LinesKing/Electronic-System-Design-ELEN90053_2021_SM2-/README.md

# Electronic-System-Design-ELEN90053_2021_SM2-
Electronic System Design (ELEN90053_2021_SM2)
