LinesKing/Electronic-System-Design-ELEN90053_2021_SM2-/Presentation.pptx

PCB 1048669

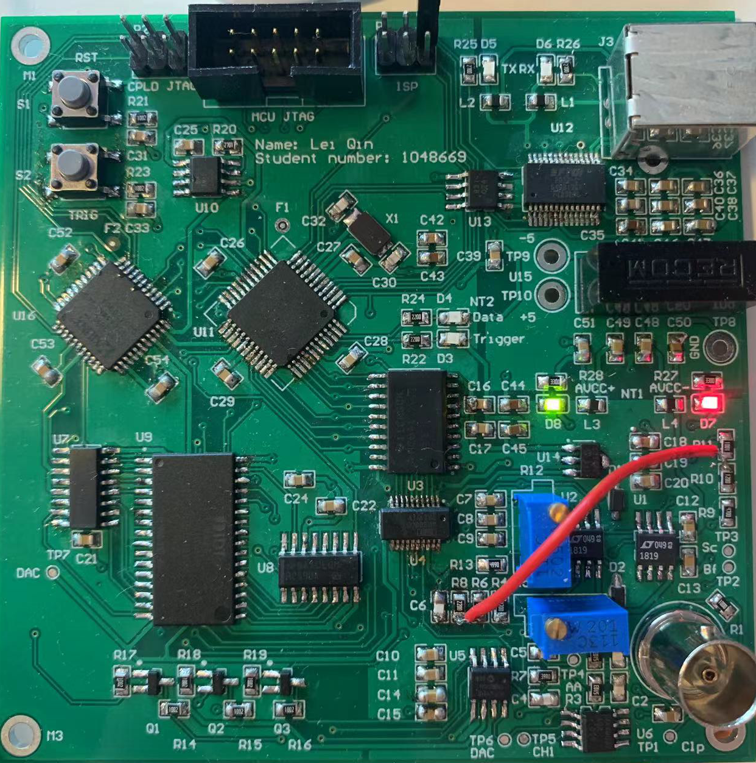
[picture p1: figure]

## Slide 2

Power

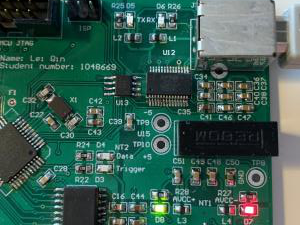
[picture p2: figure]
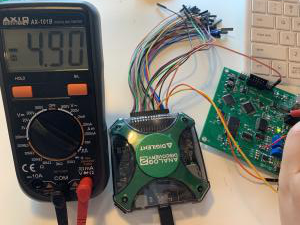
[picture p3: figure]
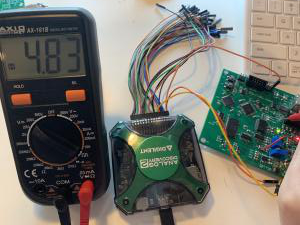
[picture p4: figure]

VCC+

VCC-

## Slide 3

Front End

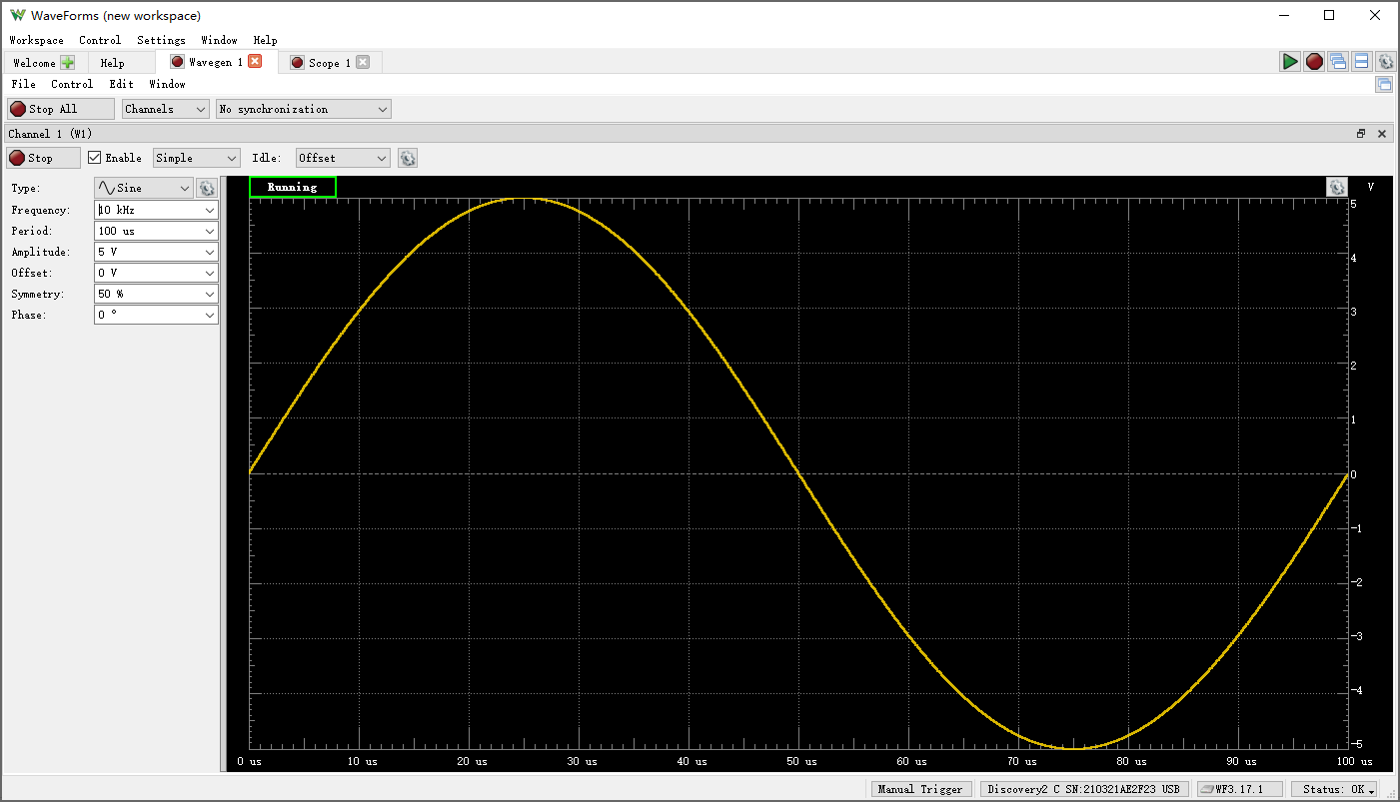
[picture p5: figure]

BNC Input

## Slide 4

Front End

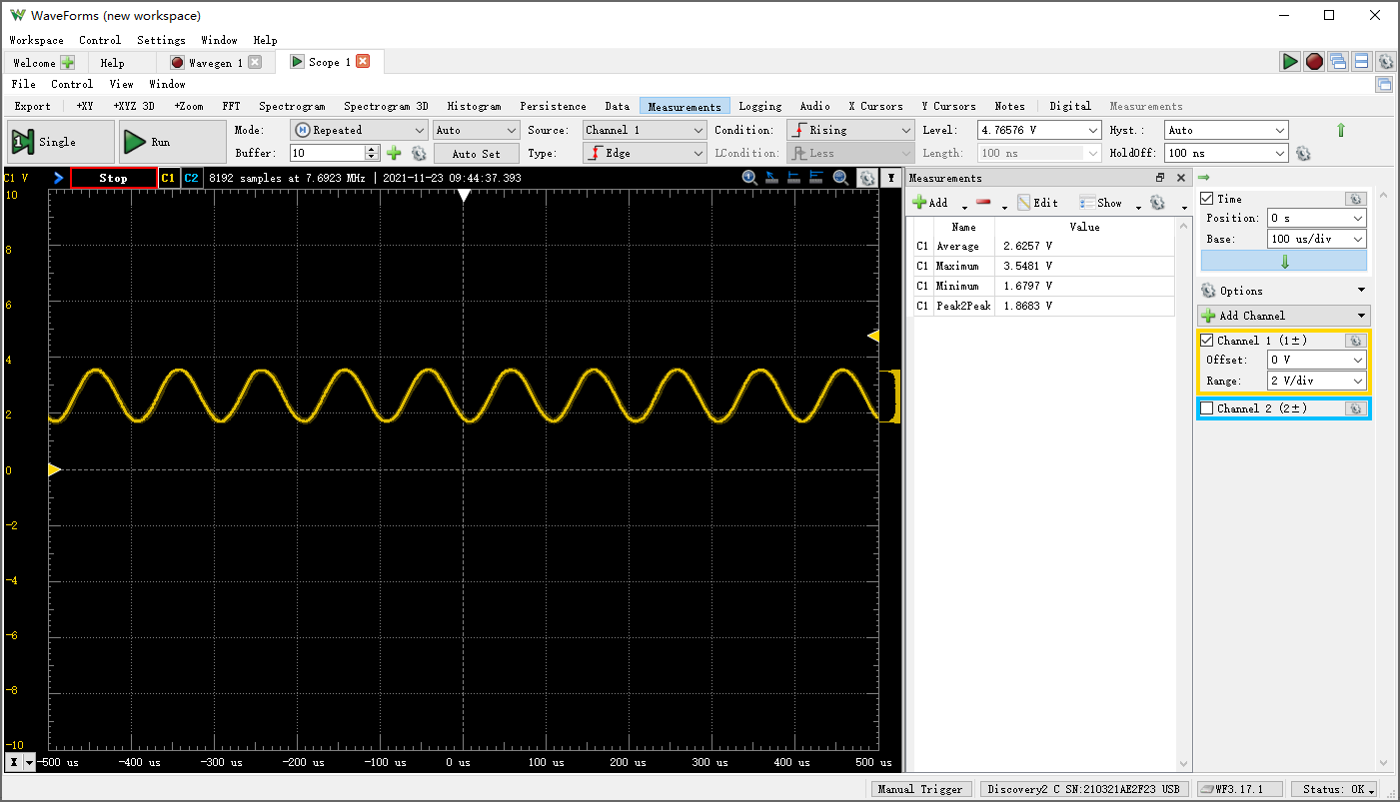
[picture p6: figure]

ADC Input

## Slide 5

GUI

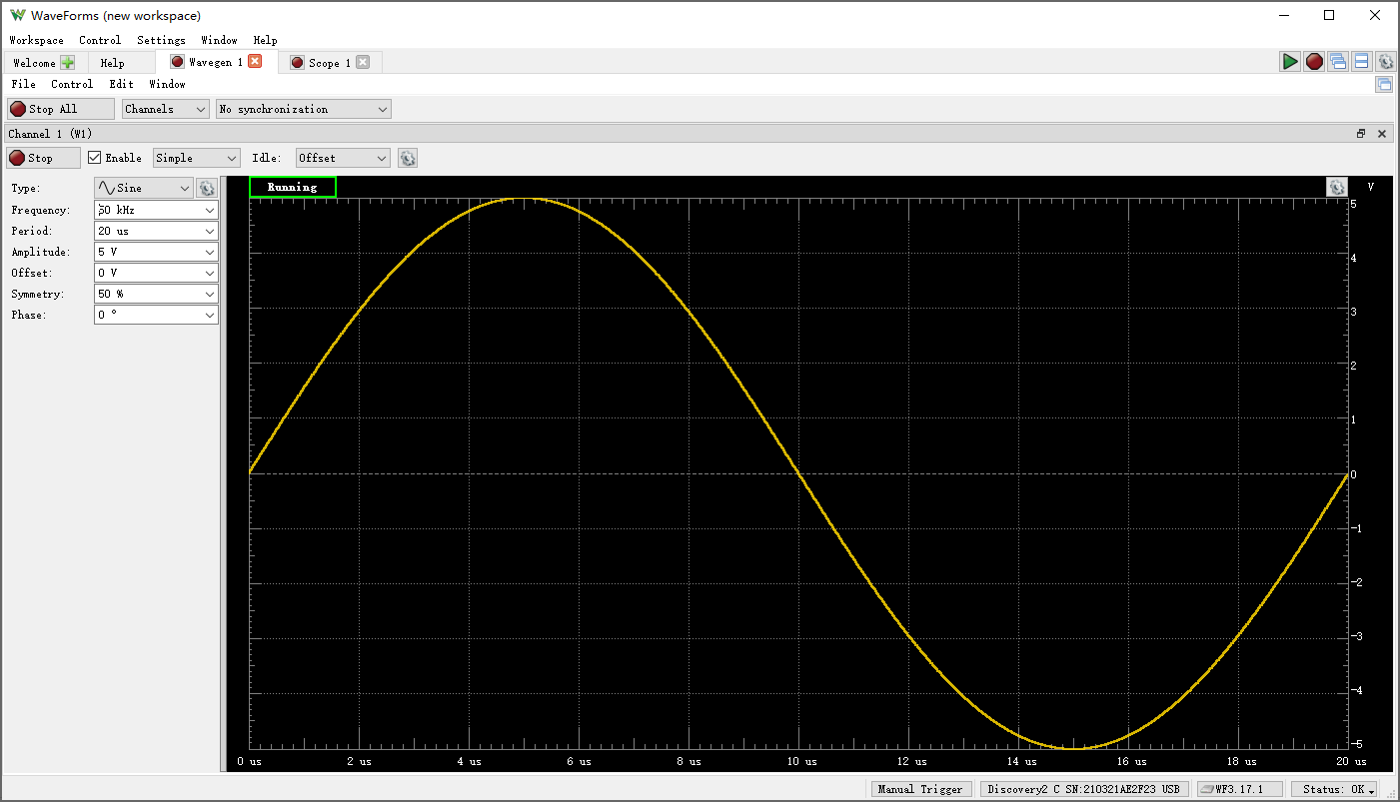
[picture p7: figure]

BNC Input

## Slide 6

GUI

GUI output

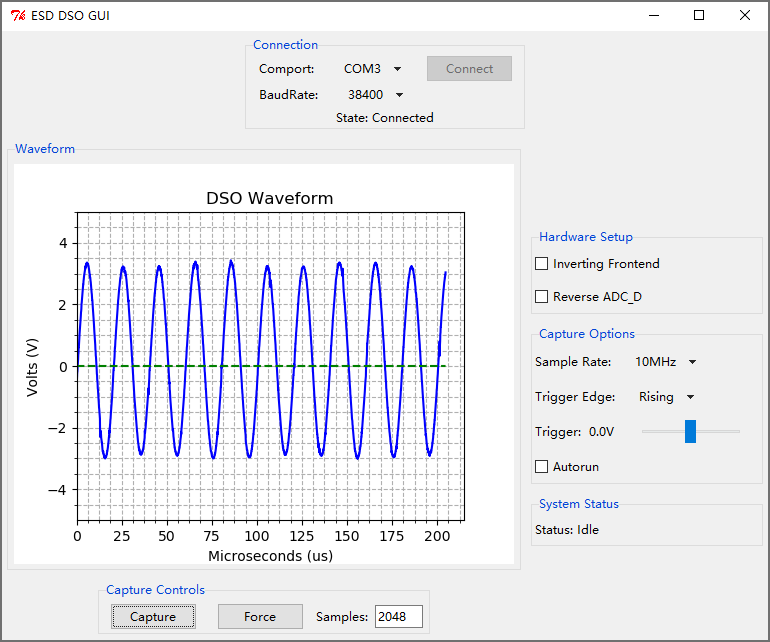
[picture p8: figure]

## Slide 7

Block Diagram

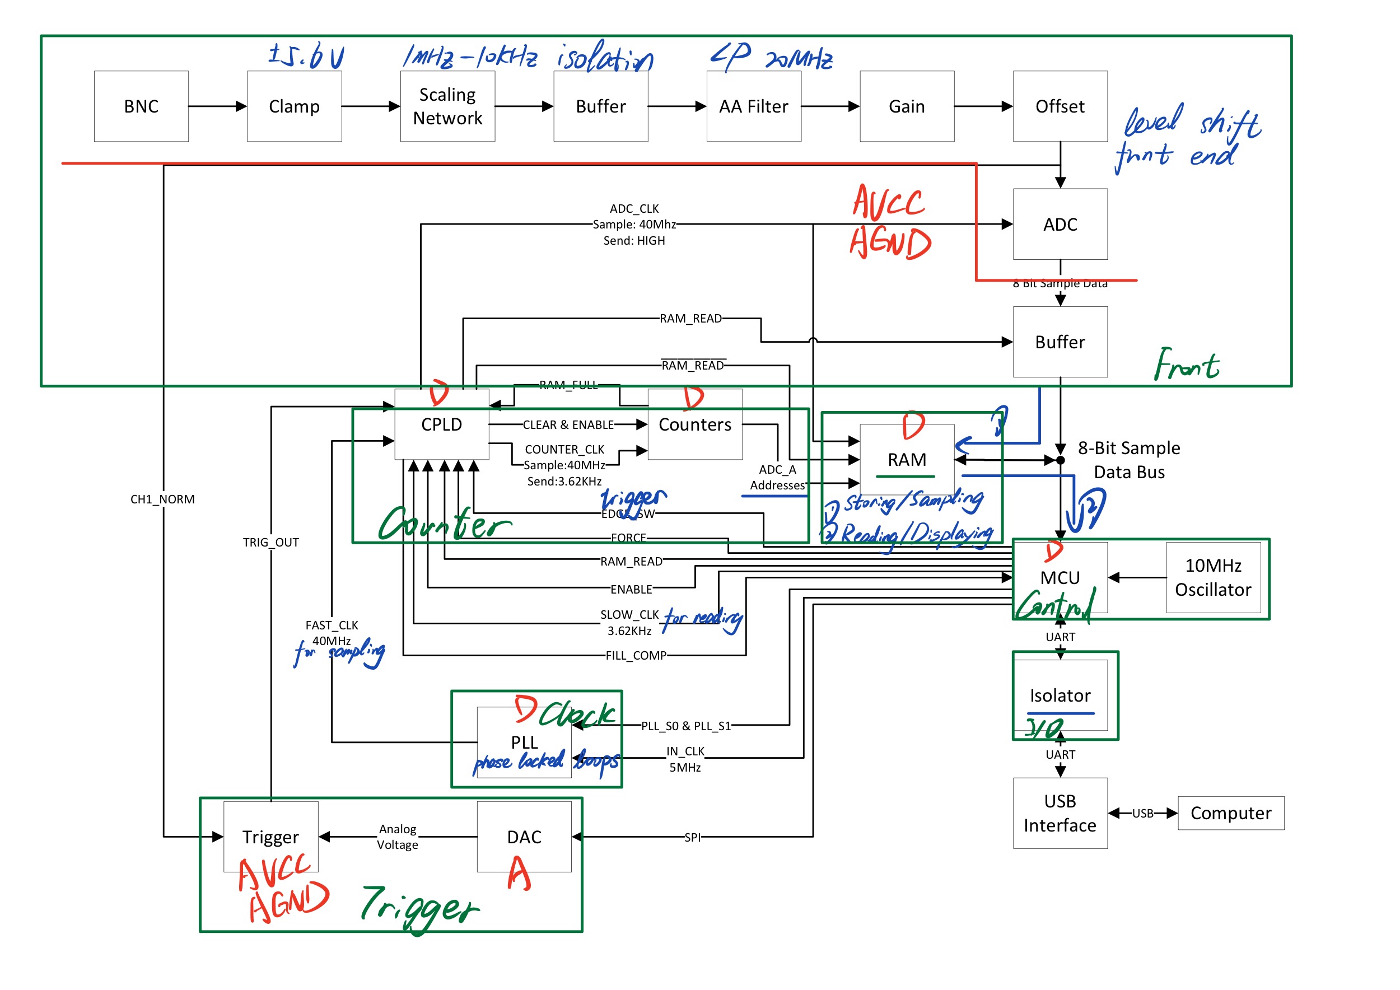
[picture p9: figure]
