LinesKing/Electronic-System-Design-ELEN90053_2021_SM2-/DSO Assignment 1/ESD_DSO_Project.pdf

# Contents

1 Schematics and Simulation Results | 1
2 Discussion | 7
3 Observation | 16
4 Summary | 17
Appendix | 18

# 1 Schematics and Simulation Results

The front end design including power, clamper, scaling, buffer, anti-aliasing filter and invert-

ing level shifter is shown in figure 1.1.

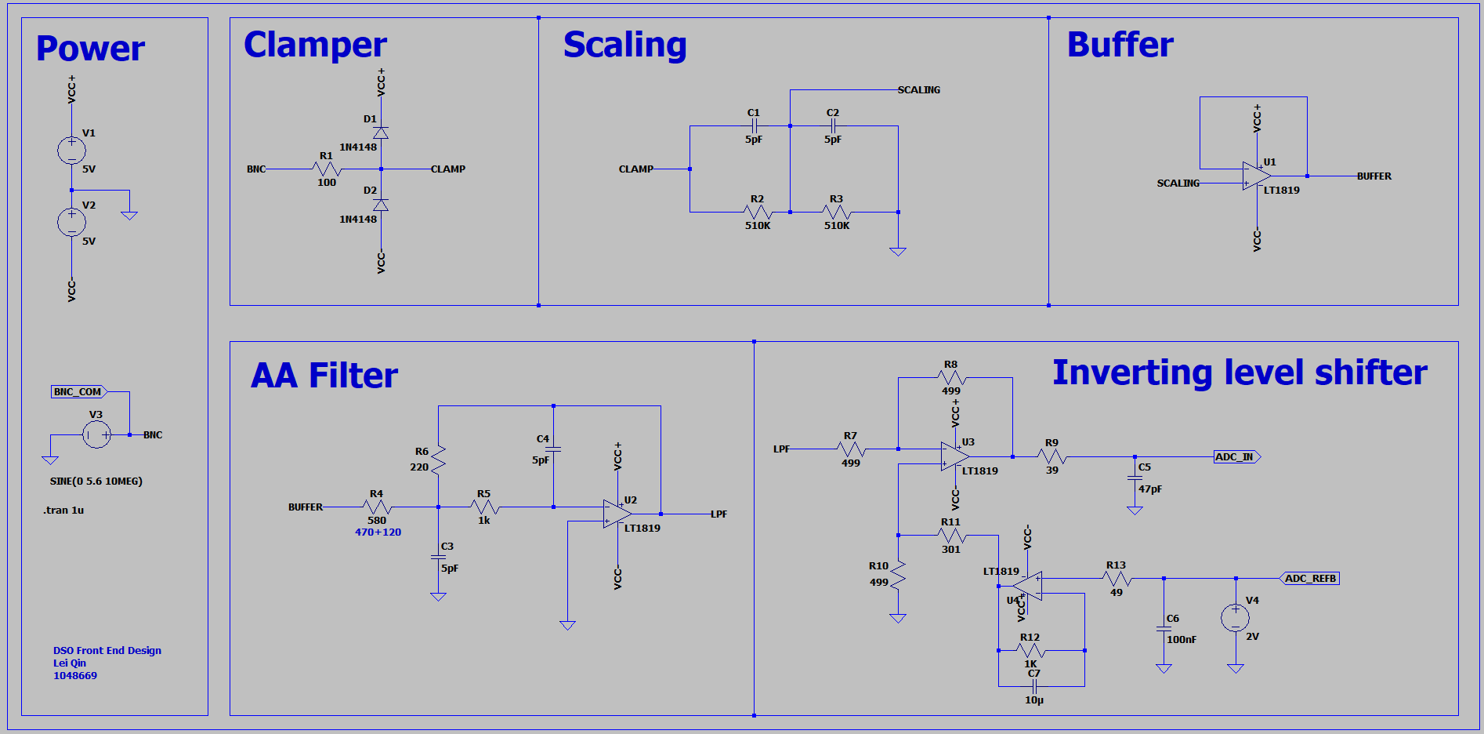
[picture p30: figure]

Figure 1.1: Front End design schematic.

## 1.1 Frequency response at the ADC input

The magnitude and phase response at the ADC input are shown in figure 1.2 and figure 1.3.

The magnitude at 1H z and 18.72M H z are about −14.68dB and −17.67dB. Thus , the cut

off frequency is about 18.72M H z. The phase at 18.72M H z is about −73.755◦ which is larger

than −180◦
. The response is of more than 20dB per decade and less than 2dB ripple.

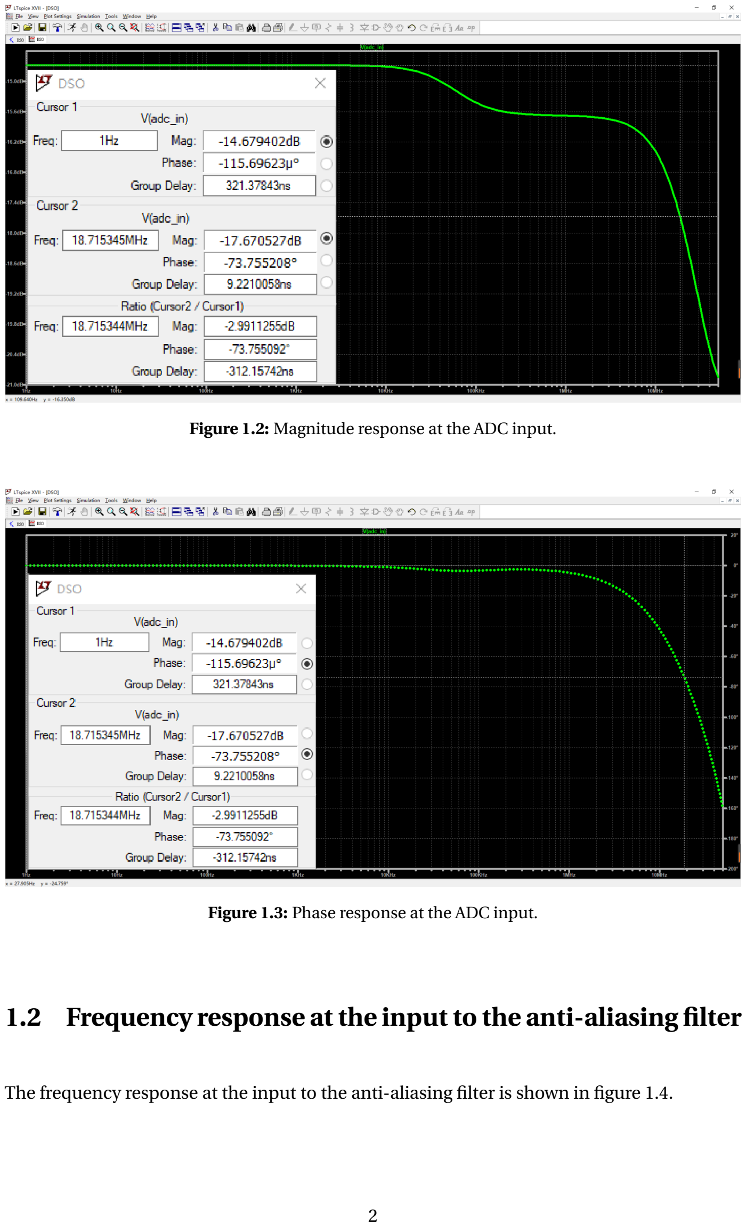
[picture p31: page 3]

Figure 1.2: Magnitude response at the ADC input.

Figure 1.3: Phase response at the ADC input.

## 1.2 Frequency response at the input to the anti-aliasing filter

The frequency response at the input to the anti-aliasing filter is shown in figure 1.4.

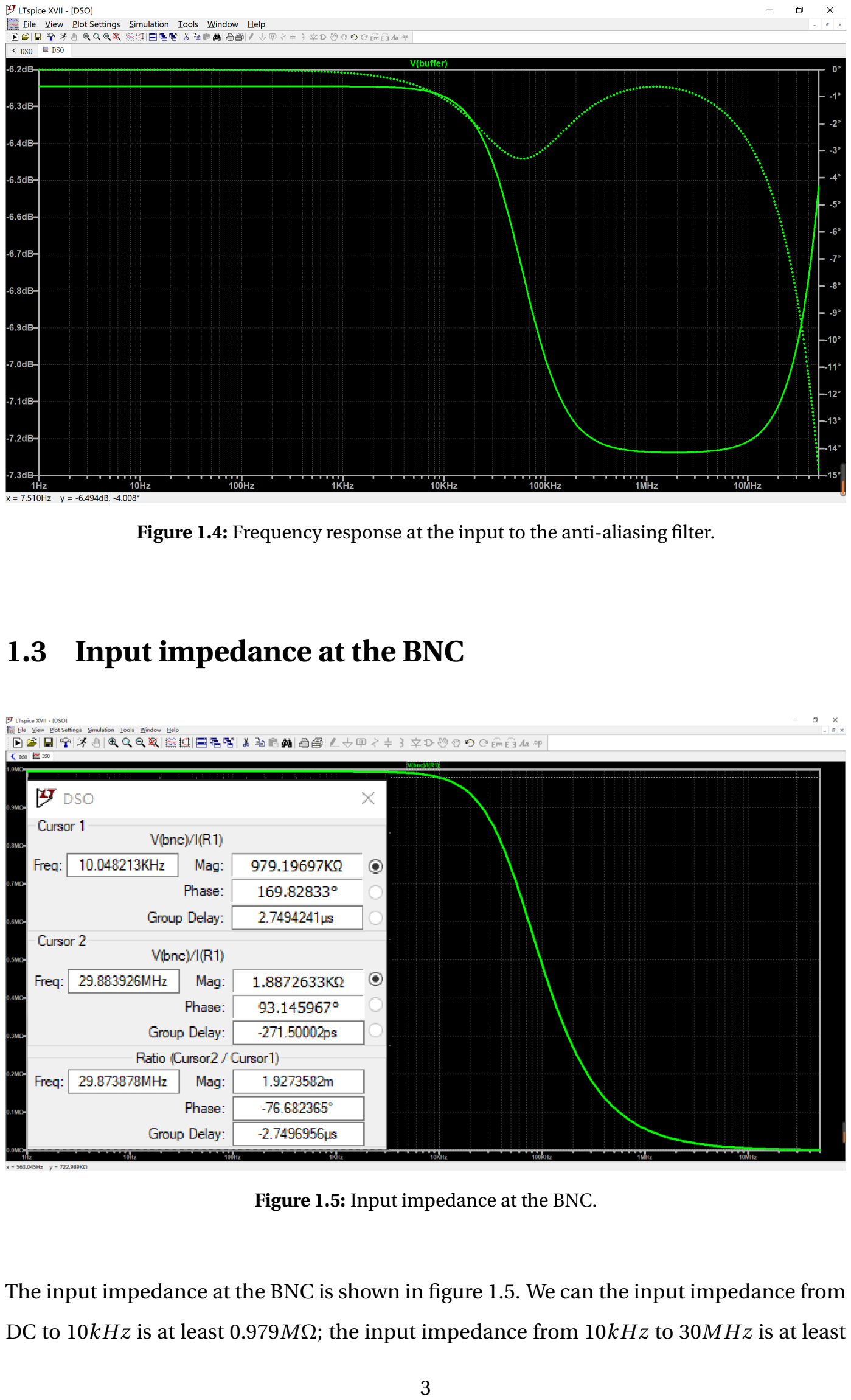
[picture p32: page 4]

Figure 1.4: Frequency response at the input to the anti-aliasing filter.

## 1.3 Input impedance at the BNC

Figure 1.5: Input impedance at the BNC.

The input impedance at the BNC is shown in figure 1.5. We can the input impedance from

DC to 10kH z is at least 0.979MΩ; the input impedance from 10kH z to 30M H z is at least

## 1.4 Clamper

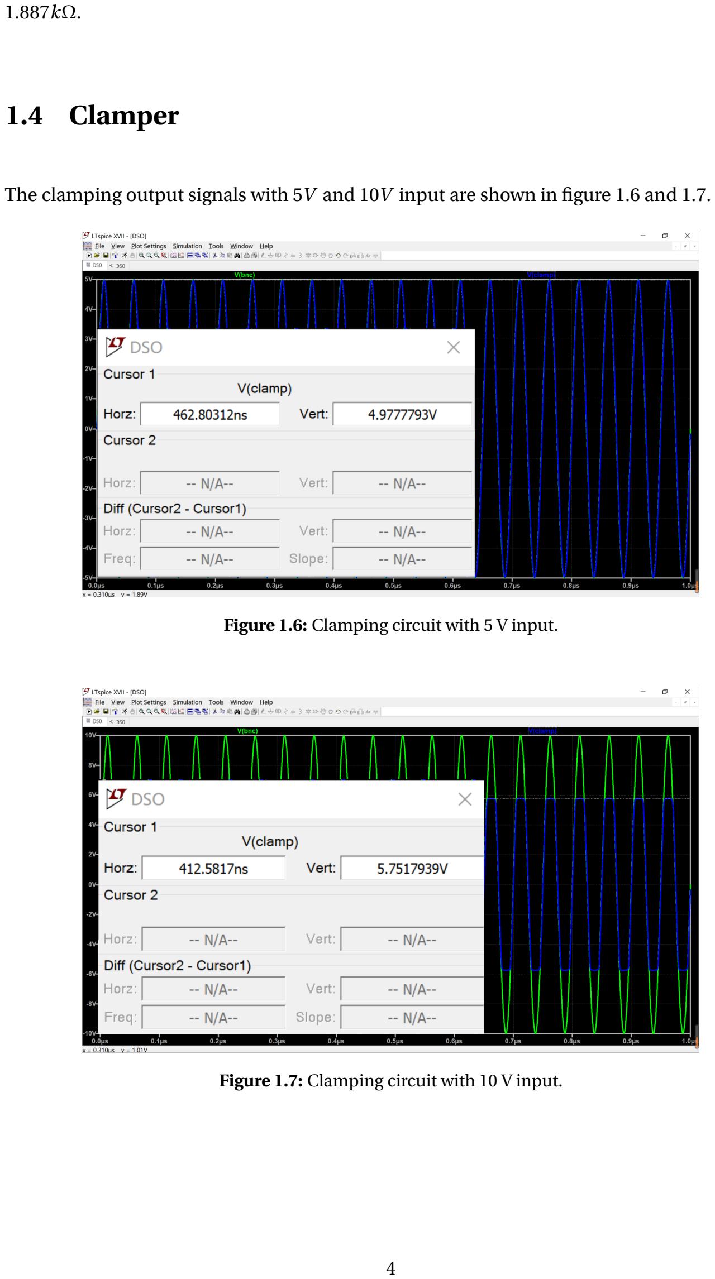
[picture p33: page 5]

1.887kΩ.

The clamping output signals with 5V and 10V input are shown in figure 1.6 and 1.7.

Figure 1.6: Clamping circuit with 5 V input.

Figure 1.7: Clamping circuit with 10 V input.

## 1.5 Power dissipation

Given that the the device must draw less than 150mA per rail when running a maxinmum

sampling rate, the maximum power at 5V is:

Pmax = 150m ×5 = 750mW

From the operating point information in Appendix and the formulation for power consump-

tion of Op-Amp in figure 1.8, we can calculate the total power dissipation in figure 1.9 is about

387.964mW which is less tha than the requirement.

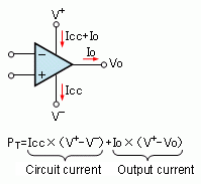
[picture p34: figure]

Figure 1.8: Power consumption of Op-Amp.

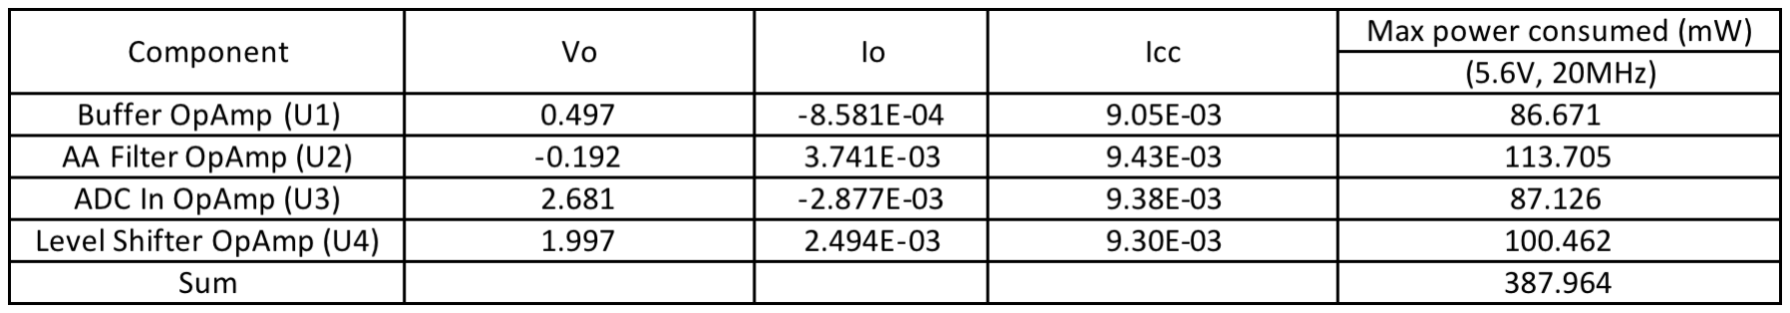
[picture p35: figure]

Figure 1.9: Power dissipation table.

## 1.6 10 kHz input signal at the input to the ADC

The input to the ADC in time domain with 10 kHz 5.6V input signal is shown in figure 1.10.

We can see the signal goes from 1.834V to 3.529V .

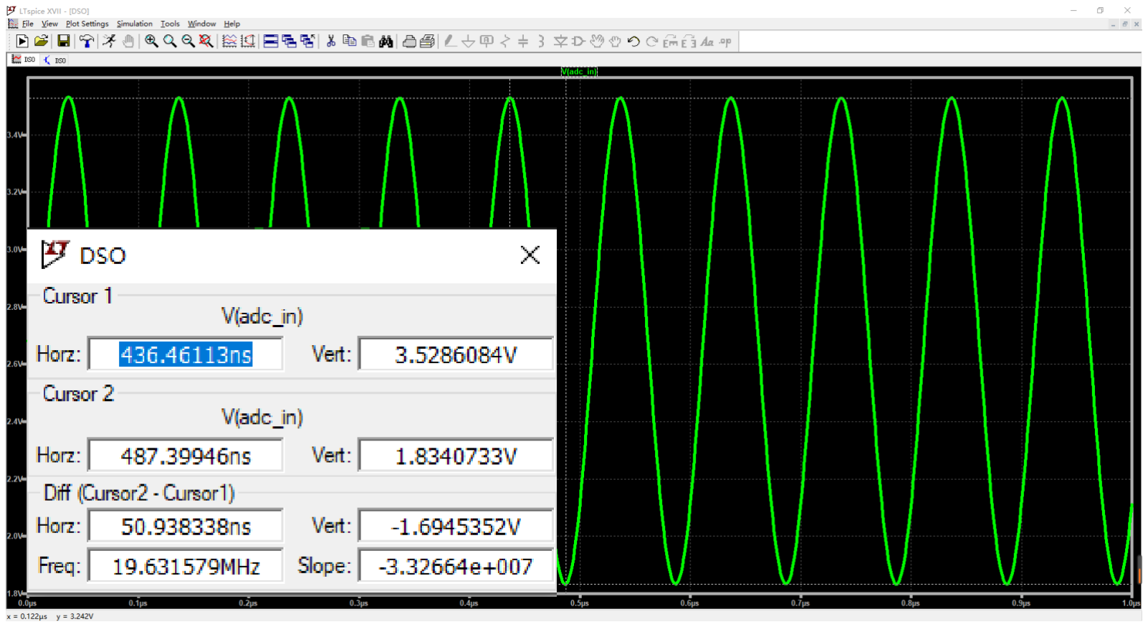
[picture p36: figure]

Figure 1.10: Time domain 10 kHz input signal at the input to the ADC.

# 2 Discussion

## 2.1 Power Block

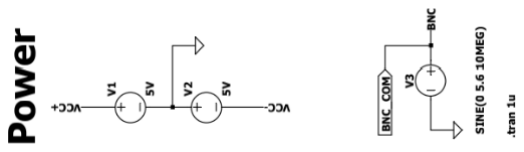
[picture p37: figure]

Figure 2.1: Power.

Vcc+ = 5V , Vcc− = −5V . The input signal is through a BNC connector.

## 2.2 Clamper Block

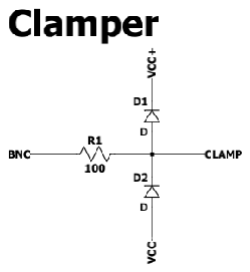
[picture p38: figure]

Figure 2.2: Clamper.

The BNC input can accept a maximum input of ±5.6V after which the input voltage is

clamped. The clamper circuit is to protect the front end circuit by clipping the input signal if

it exceeds ±5.6V .

Resistor R1 = 100Ω is to absorb the divided voltage when clamping. A small value is chosen

because when there is a high frequency input signal, the total impedance would become

very small which would increase the total current of the circuit. Since we do not want many

voltages drop on R1, we need to choose a small value for that.

The clamping output signals with 5V and 10V input are shown in figure 2.3 and 2.4. We can

see if the magnitude of input is larger than 5.6V , it would be clamped by this part circuit to

around 5.6V .

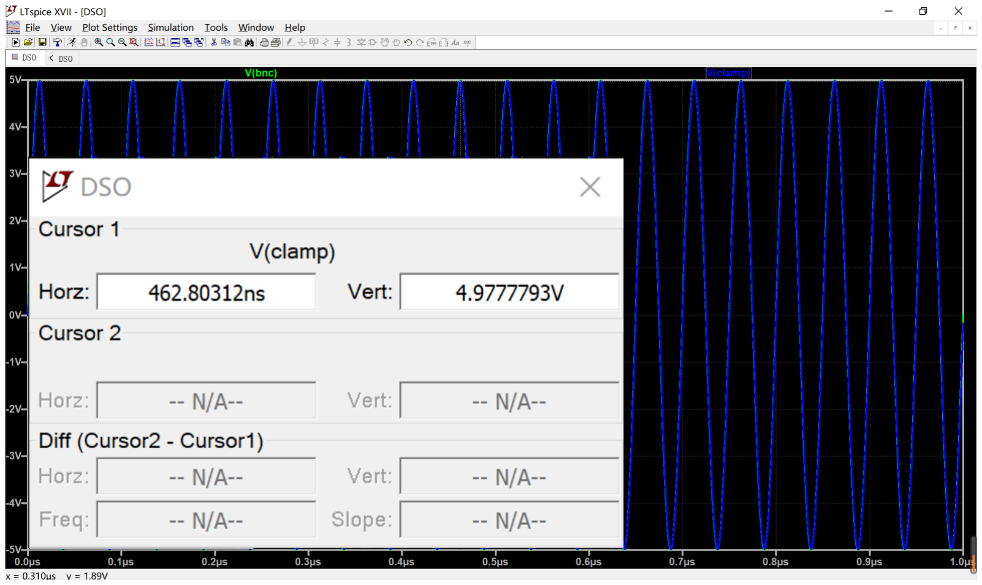
[picture p39: figure]

Figure 2.3: Clamping circuit with 5 V input.

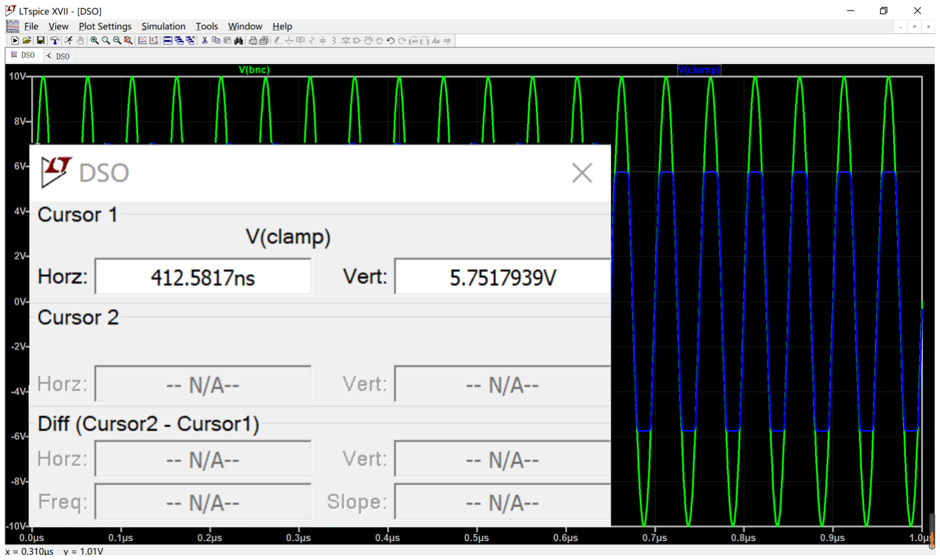
[picture p40: figure]

Figure 2.4: Clamping circuit with 10 V input.

## 2.3 Scaling Block

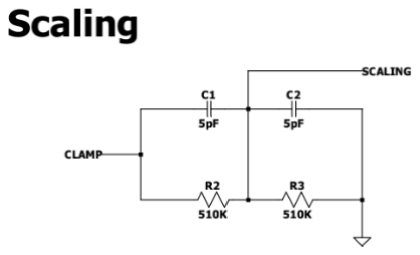
[picture p41: figure]

Figure 2.5: Scaling.

The scaling circuit is to provide enough impedance for the whole circuit and scale the input

signal for later use.

R2 = R3510kΩ, C1 = C2 = 5pF are to ensure the input has a 1MΩ ± 10% input impedance

from DC to 10kH z and at least 100Ω input impedance from 10kH z to 30M H z. The total

impedance can be calculated by:

Ztot al = (XC1||R2)+(XC2||R3)

For 10kH z: Ztot al = 2∗(

1
2πf C1

||R2) ≈ 1.02Mω;

For 30M H z: Ztot al = 2∗(

1
2πf C1

||R2) ≈ 2.12kω.

The input impedance at the BNC is shown in figure 2.6. We can the input impedance from

DC to 10kH z is at least 0.979MΩ; the input impedance from 10kH z to 30M H z is at least

1.887kΩ.

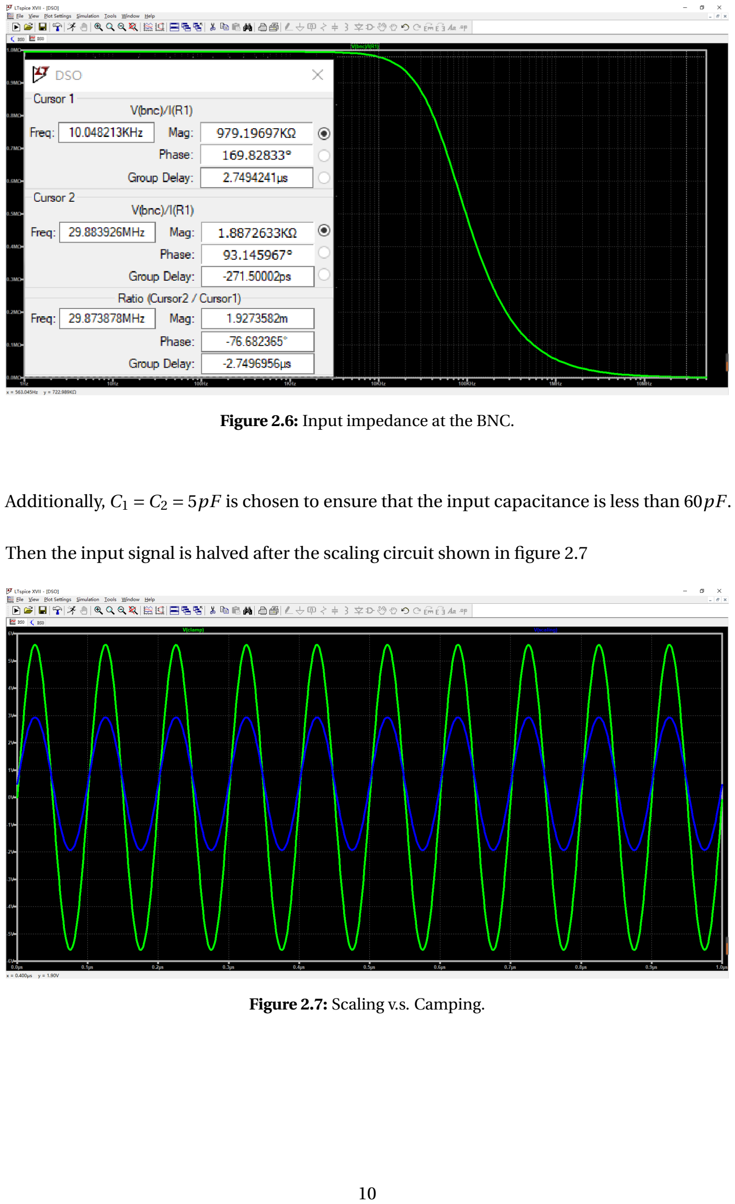
[picture p42: page 11]

Figure 2.6: Input impedance at the BNC.

Additionally, C1 = C2 = 5pF is chosen to ensure that the input capacitance is less than 60pF.

Then the input signal is halved after the scaling circuit shown in figure 2.7

Figure 2.7: Scaling v.s. Camping.

## 2.4 Buffer Block

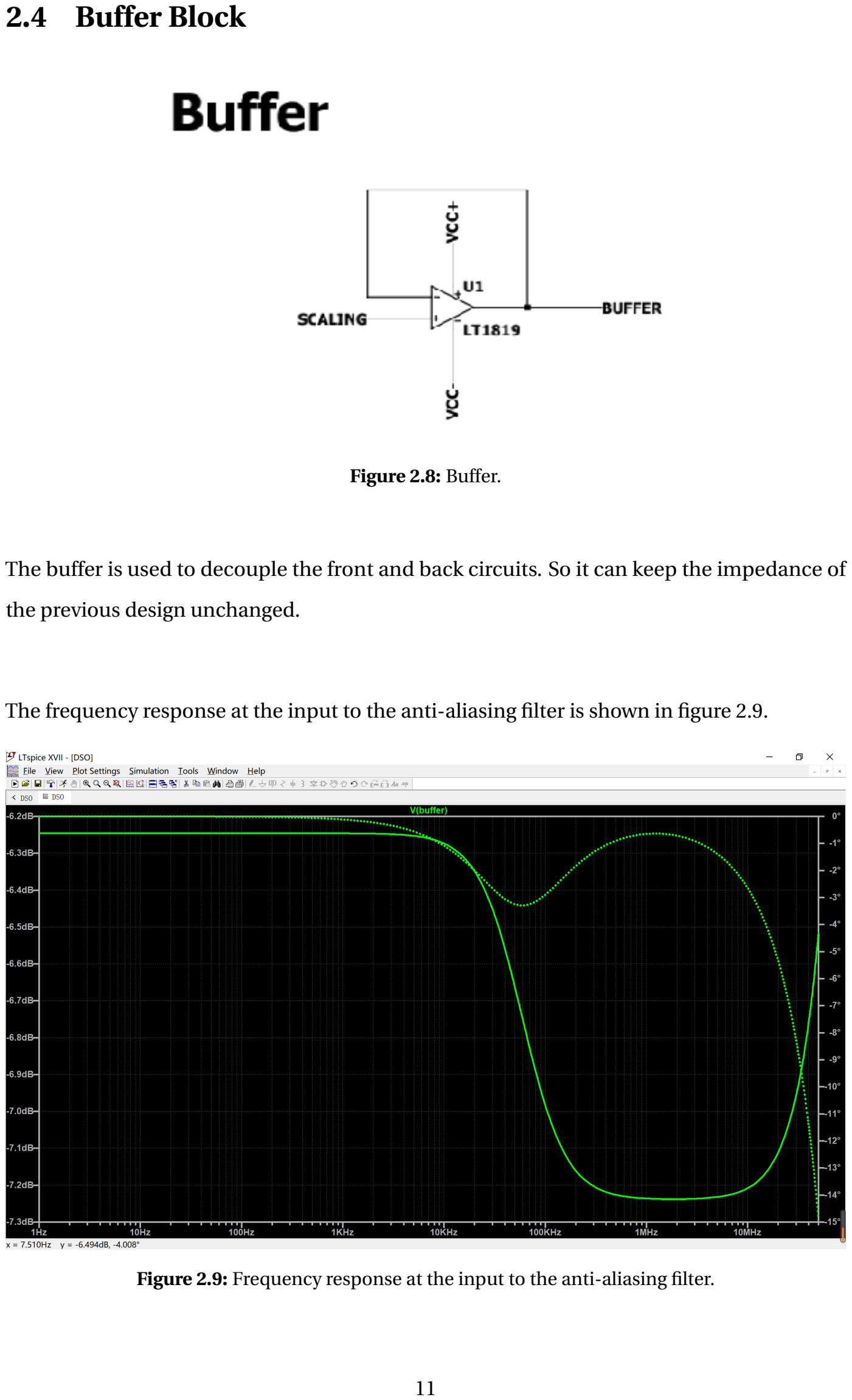
[picture p43: page 12]

Figure 2.8: Buffer.

The buffer is used to decouple the front and back circuits. So it can keep the impedance of

the previous design unchanged.

The frequency response at the input to the anti-aliasing filter is shown in figure 2.9.

Figure 2.9: Frequency response at the input to the anti-aliasing filter.

## 2.5 Anti-aliasing Filter

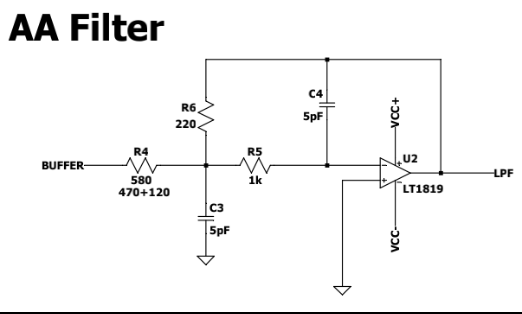
[picture p44: figure]

Figure 2.10: AA Filter.

The anti-aliasing filter is designed as a multiple feedback low-pass filter (2nd order Butter-

worth). The cut off frequency is designed as 20M H z to prevent alising of the input signal.

The DC Amplitude of the circuit is designed to satisfy the requirment of ADC input Vpp = 2V

with ±2dB maximum ripple.

We use online low-pass filter design tool with requirements to get initial values for com-

ponents, then continue to tune these values to meet all requirements: 1) fo = 20M H z, 2)

H =

2
5.6 = 0.3571, 3) ±2dB maximum ripple in passband and 4) values from BOM list.

Finally, R4 = 580Ω, R5 = 1kΩ, R6 = 220Ω and C3 = C4 = 5pF. The magnitude and phase

response at the ADC input are shown in figure 2.11 and figure 2.12. The magnitude at 1H z

and 18.72M H z are about −14.68dB and −17.67dB. Thus , the cut off frequency is about

18.72M H z. The phase at 18.72M H z is about −73.755◦ which is larger than −180◦
. The

response is of more than 20dB per decade and less than 2dB ripple.

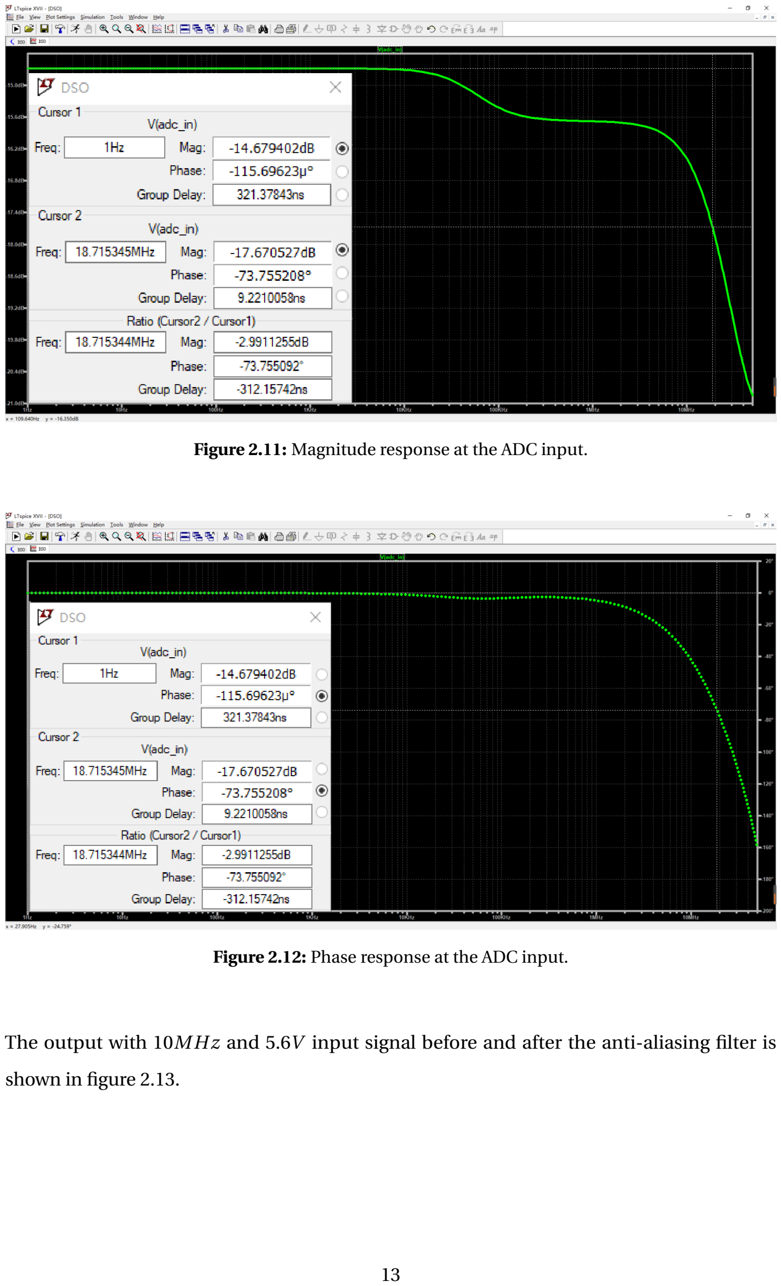
[picture p45: page 14]

Figure 2.11: Magnitude response at the ADC input.

Figure 2.12: Phase response at the ADC input.

The output with 10M H z and 5.6V input signal before and after the anti-aliasing filter is

shown in figure 2.13.

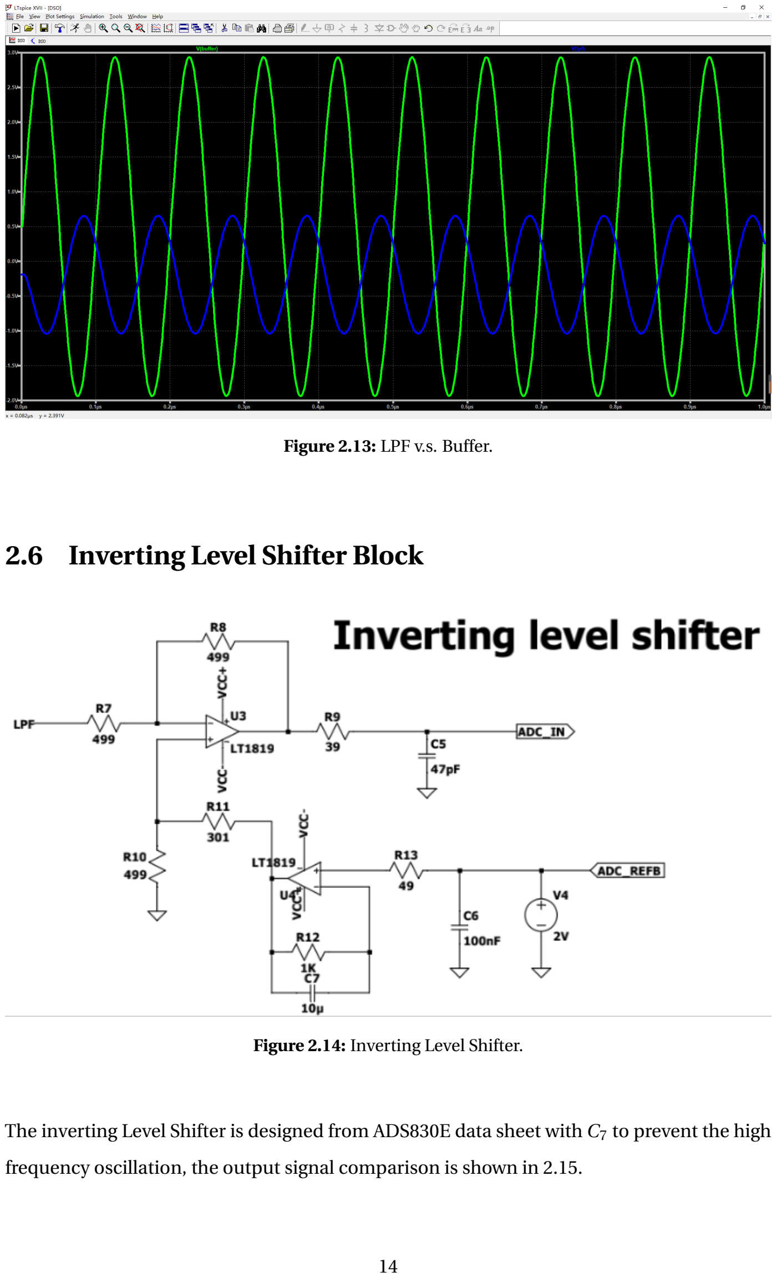
[picture p46: page 15]

Figure 2.13: LPF v.s. Buffer.

## 2.6 Inverting Level Shifter Block

Figure 2.14: Inverting Level Shifter.

The inverting Level Shifter is designed from ADS830E data sheet with C7 to prevent the high

frequency oscillation, the output signal comparison is shown in 2.15.

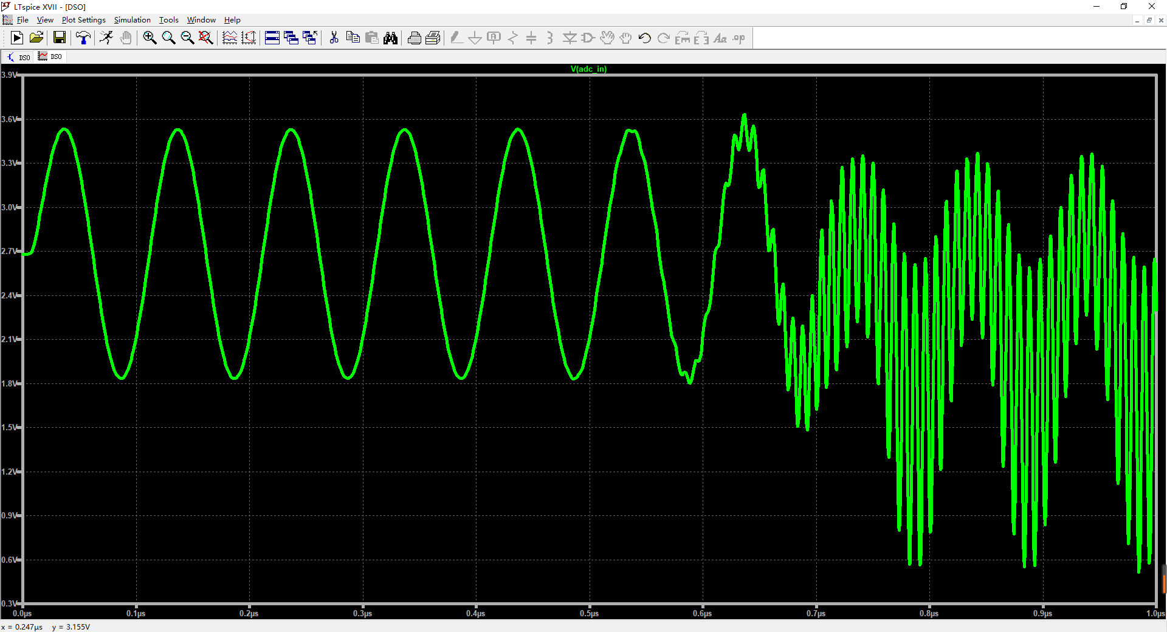
[picture p47: figure]

(a) ADC input with oscillation.

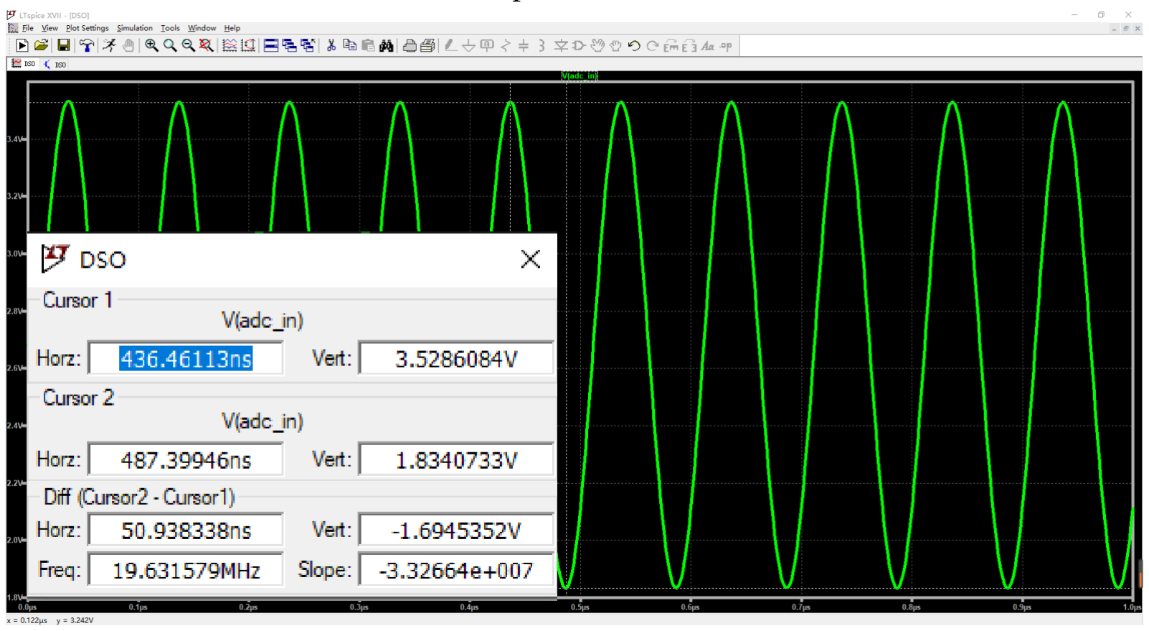
[picture p48: figure]

(b) ADC input without oscillation.

Figure 2.15: Comparison of circuits with or without C7

# 3 Observation

All core requirements are satisfied and discussed in last section. Since there might be a DC

offset due to OpAmps in the final design, we can add trim pots to adjust that.

# 4 Summary

The performance can be expected that: 1) Signal from DC to 1M H z would be presented well;

2) Signal from 1M H z to 20M H z would be shifted in phase; 3) Signal larger than 20M H z

could not be presented.

# Appendix

### Operating point

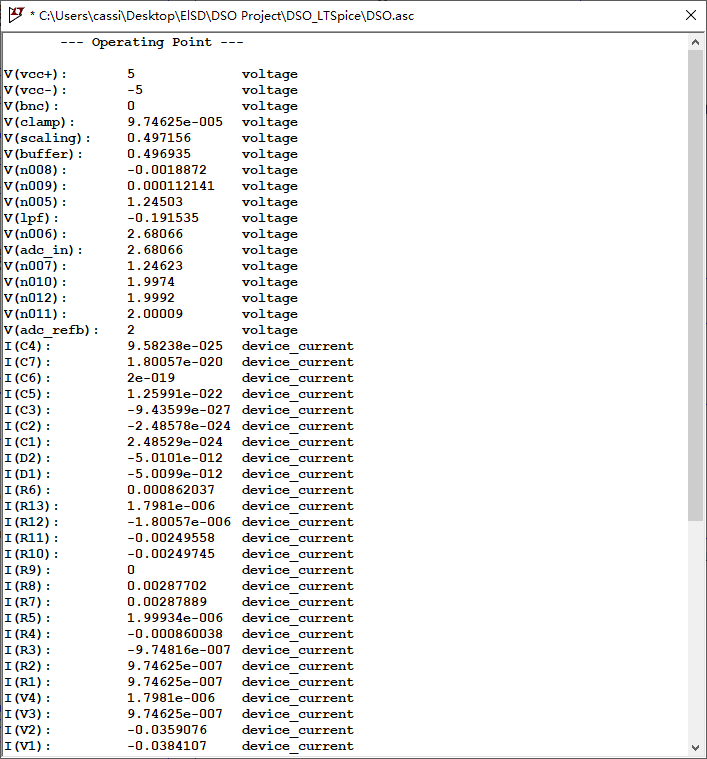
[picture p49: figure]

Figure 1: Operating point 1.

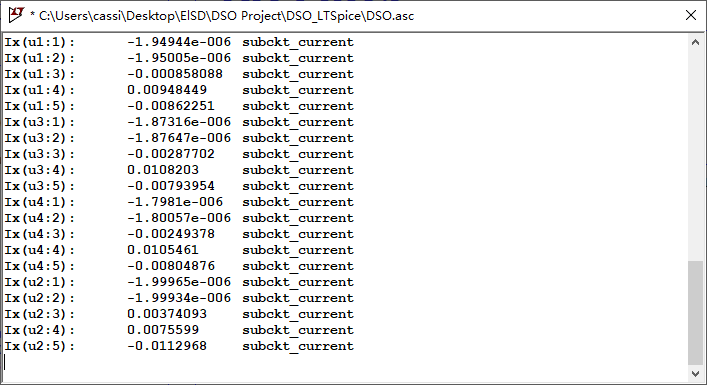
[picture p50: figure]

Figure 2: Operating point 2.
