LinesKing/Electronic-System-Design-ELEN90053_2021_SM2-/DSO Assignment 2/Project Outputs for DSO_Project/BOM/DSO_Project.xlsx

Comment | Description | Designator | Footprint | LibRef | Quantity
5pF | Capacitor | C1, C2, C5, C6 | 0805C | C | 4
100nF | Capacitor | C3, C7, C8, C9, C10, C11, C12, C13, C15, C16, C17, C18, C19, C20, C21, C22, C23, C24, C25, C26, C27, C28, C29, C31, C33, C34, C35, C36, C37, C38, C39, C40, C42, C46, C50, C51, C52, C53, C54 | 0805C | C | 39
47pF | Capacitor | C4 | 0805C | C | 1
10uF | Capacitor | C14, C47, C48, C49 | 0805C | C | 4
18pF | Capacitor | C30, C32 | 0805C | C | 2
1uF | Capacitor | C41, C43, C44, C45 | 0805C | C | 4
Diode | Diode | D1, D2 | SOD-123 | D | 2
Trigger | Light Emitting Diode | D3 | 0805D-GREEN | LED GREEN | 1
Data | Light Emitting Diode | D4 | 0805D-RED | LED RED | 1
TX | Light Emitting Diode | D5 | 0805D-GREEN | LED GREEN | 1
RX | Light Emitting Diode | D6 | 0805D-RED | LED RED | 1
AVCC- | Light Emitting Diode | D7 | 0805D-RED | LED RED | 1
AVCC+ | Light Emitting Diode | D8 | 0805D-GREEN | LED GREEN | 1
INPUT | BNC Straight | J1 | BNC_VERT | BNC | 1
JTAG | JTAG_CON | J2 | BOXEDVERT10 | JTAG_CON | 1
USB | USB B Type Connector | J3 | USBPLUG | USBPLUG | 1
300mA | Inductor | L1, L2, L3, L4 | 0805 | I | 4
Mounting Screws |  | M1, M2, M3, M4 | Mounting Screws | Mounting Screws | 4
Header 3x2 | Header, 5-Pin | P1, P2 | HDR3x2 | Header 3x2 | 2
BSS138 | N-Channel MOSFET | Q1, Q2, Q3 | SOT23 | MOSFET-N | 3
100R | Resistor | R1 | 0805 | R | 1
510K | Resistor | R2, R3 | 0805 | R | 2
470R | Resistor | R4, R9 | 0805 | R | 2
RPot | Potentiometer | R5, R12 | VR5 | RPot | 2
499R | Resistor | R6, R13 | 0805 | R | 2
39R | Resistor | R7 | 0805 | R | 1
220R | Resistor | R8, R22, R24 | 0805 | R | 3
120R | Resistor | R10 | 0805 | R | 1
1K | Resistor | R11 | 0805 | R | 1
10K | Resistor | R14, R15, R16, R17, R18, R19, R21, R23 | 0805 | R | 8
2.7K | Resistor | R20 | 0805 | R | 1
270R | Resistor | R25, R26 | 0805 | R | 2
330R | Resistor | R27, R28 | 0805 | R | 2
RESET | Momentary Push Button Switch 1P 1T 2pins | S1 | SPST PB SWITCH SMD | SW_PB_1P1T4 | 1
TRIGGER | Momentary Push Button Switch 1P 1T 2pins | S2 | SPST PB SWITCH SMD | SW_PB_1P1T4 | 1
INPUT | Pad | TP1, TP2, TP3, TP4, TP5, TP6, TP7 | Testpoin | Test Point | 7
PGND | Pad | TP8 | PIN 1.8mm | WIRE | 1
-5 | Pad | TP9 | PIN 1.8mm | WIRE | 1
+5 | Pad | TP10 | PIN 1.8mm | WIRE | 1
LT1819 | OpAmp High Frequency Dual | U1, U2 | SOIC-8 | LT1819 | 2
74HC541 | (ADV) Octal Buffer, Line Driver | U3 | SOT163-1_N | 74HC541 | 1
ADS830E | 8-Bit, 60 MSPS ADC Single-Ended / Differential Input, Internal / External Reference and Programmble Input Range, -40 to 85 degC, 20-pin SOP (DBQ20), Green (RoHS & no Sb/Br) | U4 | TI-DBQ20_L | ADS830E | 1
MCP4901 | DAC 8bit SPI | U5 | SOIC-8 | MCP4901 | 1
MAX9032 | Dual Comparator | U6 | SOIC-8 | MAX9032 | 1
74HC590 | 8-Bit Binary Counter Register | U7, U8 | SOIC-16 | 74HC590 | 2
71V124SA10PHG8 | SRAM 128k x 8 | U9 | TSOP-32 | CY7C1019D | 1
PT7C4511 | PLL Clock Multiplier | U10 | SOIC-8 | PT7C4511 | 1
ATMEGA16 | ATMEGA16 Microcontroller | U11 | QFP-48 | ATMEGA16 | 1
FT232RL | USB to Serial bridge | U12 | SSOP-28 | FT232RL | 1
Si8421 | Dual Channel Digital Isolator Both Ways | U13 | SOIC-8 | Si8421 | 1
MCP1700T-3302E/MB | Low Quiescent Current LDO, 3-Pin SOT-89, Extended Temperature, Tape and Reel | U14 | SOT89 | MCP1700T | 1
RD0505D | (ADV) DC to DC converter 5V in +-5V out | U15 | SIP_NMG | RD0505D | 1
XC9536XL-10VQ44C | FastFLASH XC900XL, 3.3V High-Performance 36 Macrocell CPLD, 34 User I/Os, 44-Pin VQFP, Speed Grade 10, Commercial Grade | U16 | VQ44_L | XC9536XL-10VQG44C | 1
10Mhz | Crystal Oscillator | X1 | XTAL_FLAT_SMD | XTAL | 1
