LinesKing/Electronic-System-Design-ELEN90053_2021_SM2-/(list of files, cad)

Other CAD files:
DSO Assignment 1/DSO_Altium_Design/DSO_Altium_Design/Project Outputs for DSO_Project/DSO_Project.PRT
DSO Assignment 2/Project Outputs for DSO_Project/DSO_Project.PRT
