LinesKing/Electronic-System-Design-ELEN90053_2021_SM2-/DSO Assignment 1/DSO.asc

C1: cap; 5pF
C2: cap; 5pF
C3: cap; 5pF
C4: cap; 5pF
C5: cap; 47pF
C6: cap; 100nF
C7: cap; 10µ
D1: diode; 1N4148
D2: diode; 1N4148
R1: res; 100
R2: res; 510K
R3: res; 510K
R4: res; 580
R5: res; 1k
R6: res; 220
R7: res; 499; tol=1 pwr=0.1
R8: res; 499
R9: res; 39
R10: res; 499
R11: res; 301
R12: res; 1K
R13: res; 49
U1: LT1819
U2: LT1819
U3: LT1819
U4: LT1819
V1: voltage; 5V
V2: voltage; 5V
V3: voltage; SINE(0 5.6 10MEG); AC 1
V4: voltage; 2V
Named nets: 0, VCC+, VCC-, BNC, CLAMP, SCALING, BUFFER, LPF, ADC_IN, ADC_REFB, BNC_COM
.tran 1u
DSO Front End Design
Lei Qin
1048669
Power
Clamper
Scaling
Buffer
AA Filter
Inverting level shifter
470+120
