LinesKing/Electronic-System-Design-ELEN90053_2021_SM2-/(list of files, drawings)

Other design files:
DSO Assignment 1/DSO_Altium_Design/DSO_Altium_Design/DSO.PcbDoc
DSO Assignment 1/DSO_Altium_Design/DSO_Altium_Design/DSO.PcbLib
DSO Assignment 1/DSO_Altium_Design/DSO_Altium_Design/DSO.SCHLIB
DSO Assignment 1/DSO_Altium_Design/DSO_Altium_Design/DSO_ADC.SchDoc
DSO Assignment 1/DSO_Altium_Design/DSO_Altium_Design/DSO_Clock.SchDoc
DSO Assignment 1/DSO_Altium_Design/DSO_Altium_Design/DSO_Control.SchDoc
DSO Assignment 1/DSO_Altium_Design/DSO_Altium_Design/DSO_Counters.SchDoc
DSO Assignment 1/DSO_Altium_Design/DSO_Altium_Design/DSO_CPLD.SchDoc
DSO Assignment 1/DSO_Altium_Design/DSO_Altium_Design/DSO_Front.SchDoc
DSO Assignment 1/DSO_Altium_Design/DSO_Altium_Design/DSO_IO.SchDoc
DSO Assignment 1/DSO_Altium_Design/DSO_Altium_Design/DSO_Power.SchDoc
DSO Assignment 1/DSO_Altium_Design/DSO_Altium_Design/DSO_Project.PrjPCB
DSO Assignment 1/DSO_Altium_Design/DSO_Altium_Design/DSO_RAM.SchDoc
DSO Assignment 1/DSO_Altium_Design/DSO_Altium_Design/DSO_Top.SchDoc
DSO Assignment 1/DSO_Altium_Design/DSO_Altium_Design/DSO_Trig.SchDoc
DSO Assignment 2/DSO.PcbLib
DSO Assignment 2/DSO.SCHLIB
DSO Assignment 2/DSO_ADC.SchDoc
DSO Assignment 2/DSO_Clock.SchDoc
DSO Assignment 2/DSO_Control.SchDoc
DSO Assignment 2/DSO_Counters.SchDoc
DSO Assignment 2/DSO_CPLD.SchDoc
DSO Assignment 2/DSO_Front.SchDoc
DSO Assignment 2/DSO_IO.SchDoc
DSO Assignment 2/DSO_Power.SchDoc
DSO Assignment 2/DSO_Project.PrjPCB
DSO Assignment 2/DSO_RAM.SchDoc
DSO Assignment 2/DSO_Top.SchDoc
DSO Assignment 2/DSO_Trig.SchDoc
Workshop 2/Altium_Workshop_2020.PcbLib
Workshop 2/Altium_Workshop_2020.SchLib
Workshop 2/Workshop2/PCB1.PcbDoc
Workshop 2/Workshop2/Sheet1.SchDoc
Workshop 2/Workshop2/Workshop2.PrjPcb
Workshop 3/DSO_Altium_Template_2020_v1/DSO_Altium_Template_2020_v1/DSO.PcbDoc
Workshop 3/DSO_Altium_Template_2020_v1/DSO_Altium_Template_2020_v1/DSO.PcbLib
Workshop 3/DSO_Altium_Template_2020_v1/DSO_Altium_Template_2020_v1/DSO.PrjPCB
Workshop 3/DSO_Altium_Template_2020_v1/DSO_Altium_Template_2020_v1/DSO.SCHLIB
Workshop 3/DSO_Altium_Template_2020_v1/DSO_Altium_Template_2020_v1/DSO_ADC.SchDoc
Workshop 3/DSO_Altium_Template_2020_v1/DSO_Altium_Template_2020_v1/DSO_Clock.SchDoc
Workshop 3/DSO_Altium_Template_2020_v1/DSO_Altium_Template_2020_v1/DSO_Control.SchDoc
Workshop 3/DSO_Altium_Template_2020_v1/DSO_Altium_Template_2020_v1/DSO_Counters.SchDoc
Workshop 3/DSO_Altium_Template_2020_v1/DSO_Altium_Template_2020_v1/DSO_CPLD.SchDoc
Workshop 3/DSO_Altium_Template_2020_v1/DSO_Altium_Template_2020_v1/DSO_Front.SchDoc
Workshop 3/DSO_Altium_Template_2020_v1/DSO_Altium_Template_2020_v1/DSO_IO.SchDoc
Workshop 3/DSO_Altium_Template_2020_v1/DSO_Altium_Template_2020_v1/DSO_Power.SchDoc
Workshop 3/DSO_Altium_Template_2020_v1/DSO_Altium_Template_2020_v1/DSO_RAM.SchDoc
Workshop 3/DSO_Altium_Template_2020_v1/DSO_Altium_Template_2020_v1/DSO_Top.SchDoc
Workshop 3/DSO_Altium_Template_2020_v1/DSO_Altium_Template_2020_v1/DSO_Trig.SchDoc
